thahirsprojects/nano/case/images/back.png

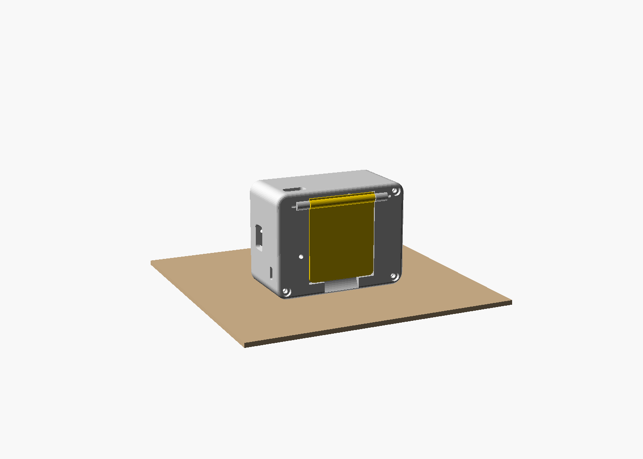
case/images/back.png
