thahirsprojects/nano/case/images/standing.png

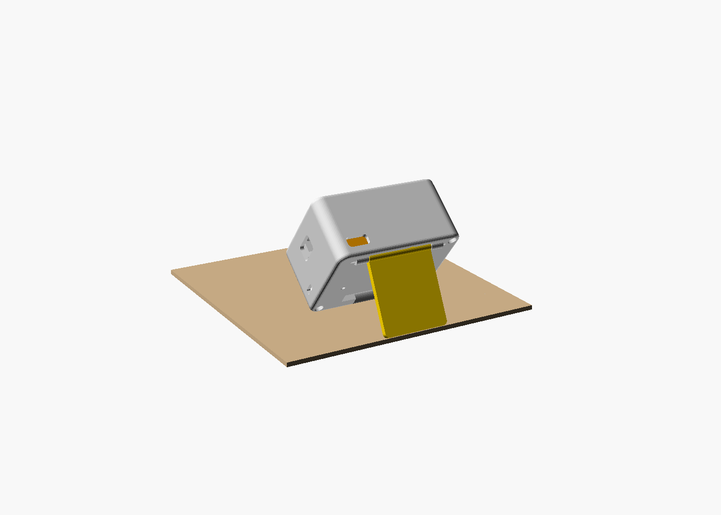
case/images/standing.png
