thahirsprojects/nano/case/stl/nano_kickstand.stl

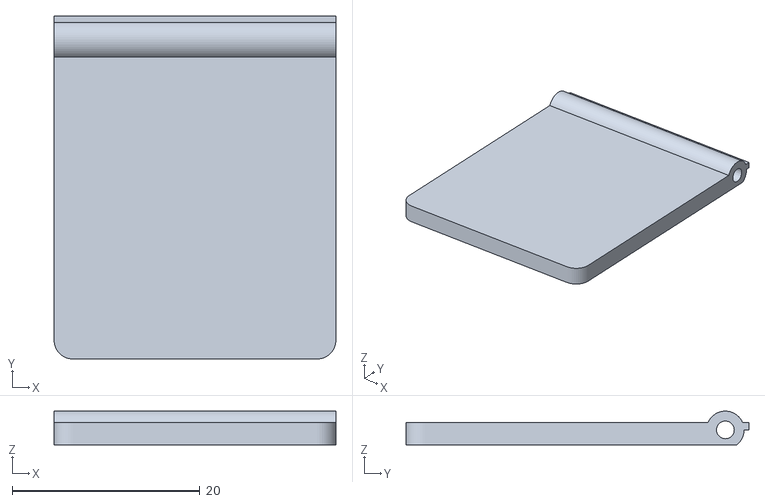
[picture p6: CAD file, 2026-10-23]
case/stl/nano_kickstand.stl
30.0 x 36.5 x 3.60
