thahirsprojects/nano/case/stl/nano_lid.stl

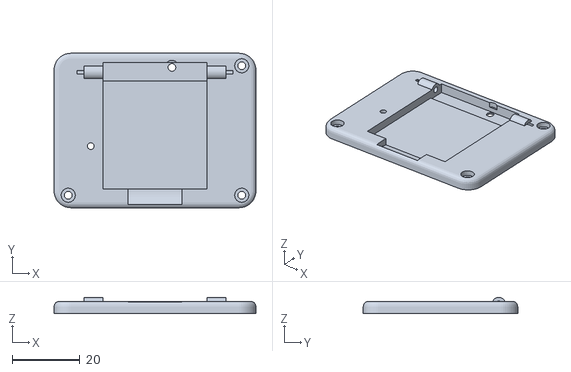
[picture p7: CAD file, 2026-10-23]
case/stl/nano_lid.stl
59.6 x 45.6 x 4.80
