thahirsprojects/nano/case/stl/nano_shell.stl

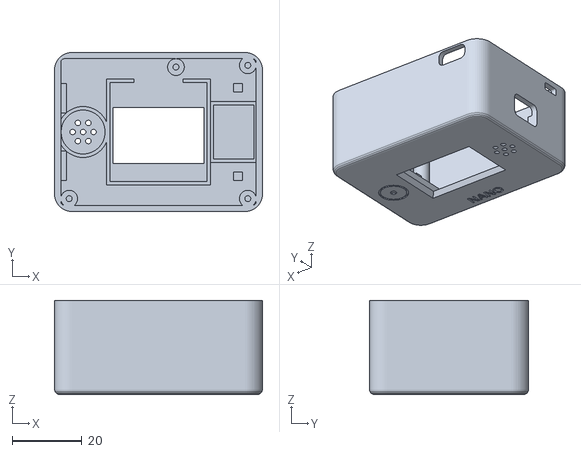
[picture p8: CAD file, 2026-10-23]
case/stl/nano_shell.stl
59.6 x 45.6 x 27.0
