thahirsprojects/nano/case/stl/nano_plate.stl

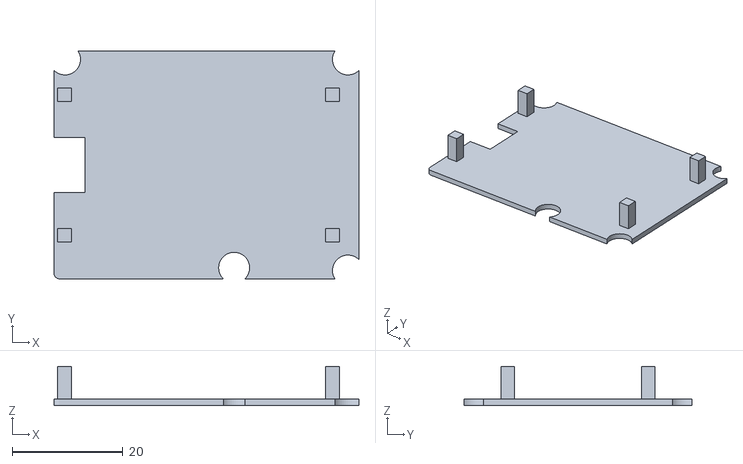
[picture p9: CAD file, 2026-10-23]
case/stl/nano_plate.stl
55.2 x 41.2 x 7.10
