thahirsprojects/nano/(commit log)

2026-10-23 Fix BLE, music and water handling; add find, eye style and water log
    - Send notifications with raw bytes so it builds on ESP32 core 2.x and 3.x
    - Grow the command queue to 16 and raise the MTU to 517
    - Music updates no longer interrupt notifications or reminders; paused
    music returns to the eyes after 30 s; clear music on disconnect
    - Water reminders only during active, non-sleep hours; active hours can
    cross midnight
    - Strip non-ASCII text, fit long names on the boot screen, validate and
    only save settings when they change
    - New: E|<0-3> eye style, F find-my-Nano, H|WATER and E|<n> sent to phone
    [nano.ino]
2026-10-23 Add passive buzzer sounds on P25
    - Non-blocking tune player on LEDC (works on ESP32 core 2.x and 3.x)
    - Sounds: notification chirp, ringing call (R|, stopped by tap or Q),
    water tune, find-my-Nano beeps, petting chirp, tap click, startup
    chime, birthday song
    - B|on|volume|flags sound settings saved to flash; P|<id> previews
    - Quiet during sleep hours (except find), optional quiet outside awake hours
    - BUZZER_DIRECT keeps the pin at its weakest drive strength while the
    buzzer is wired without a resistor or transistor
    [nano.ino]
2026-10-23 Fix notifications/calls closing instantly; add mute, DND and phone battery
    - Screen timers used now - modeStart where modeStart could be later than
    now, wrapping to a huge value: notifications, calls, water and find
    screens closed immediately while their sound still played
    - Incoming call screen stays up while ringing and closes on Q
    - Z|minutes timed mute, D|0/1 phone Do Not Disturb, L|percent|charging
    phone battery on the clock screen, battery logo for the low-battery alert
    - Credit Mohamed Thahir in the header
    [nano.ino]
2026-10-23 Add 3D-printed pocket case with battery and kickstand
    OpenSCAD source and print-ready STLs for a 59.6 x 45.6 x 30.6 mm case:
    shell (OLED window, speaker grille, thin touch spot), battery plate
    (pegs hold the ESP32), lid with screw holes and charge LED hole, and a
    fold-out kickstand with a 66 degree stop. Includes collision checks,
    renders, parts list, wiring and assembly guide.
    [nano_case.scad, nano_kickstand.stl, nano_lid.stl, nano_plate.stl, nano_shell.stl]
2026-10-24 Ring until the call is answered or declined; ringtones; Buddy face
    - Incoming calls (R|) ring until Q (answered, declined or missed), a tap,
    a Bluetooth disconnect or a 3-minute safety stop; calls ring at any
    hour (mute and phone Do Not Disturb still apply)
    - Sounds play from a FreeRTOS task so melodies keep exact timing while
    the screen redraws
    - 8 ringtones chosen with B|...|<ringtone>: classic bell, Gran Vals
    (Nokia-style), marimba (iPhone-style, original), digital, Fur Elise,
    Westminster chime, arcade, Ode to Joy; P|r<n> previews, P|s stops
    - New default eye style "Buddy": wide 8-bit eyes with a sharp brow cut
    and a tiny ^ mouth (E|4)
    - Verified with arduino-cli: compiles for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
    [nano.ino]
2026-10-26 Add 4 eye styles, focus timer, local gestures; harden error handling
    New eye styles (E|0-7): Grin and Robot (with a mouth), Drowsy (no mouth,
    selectable any time, distinct from the time-based Tired/Sleep states).
    New features, all on the existing hardware:
    - Focus/countdown timer (X|<minutes>, 0 cancels): big MM:SS + progress
    bar, chimes when it reaches zero, capped at 3 hours
    - Local gestures on Nano, no phone needed: holding past the pet
    threshold (~2.5 s) toggles mute; holding the clock screen (~1.2 s)
    turns it into a plain white "torch" screen, capped at a minute
    - Auto-dim during sleep hours; a small pixel drift on the eyes/clock
    every few minutes to reduce OLED burn-in
    - A "Mu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
    [nano.ino]
